Infringer13/Case-Feeder-Pro-Waveshare/README.md

# Case Feeder Pro

Firmware for an automatic brass case feeder, a bullet feeder, or both run
side by side from one controller, with a touchscreen to control them.

- **Controller:** BigTreeTech SKR Pico V1.0 (RP2040). It drives the feeder
  motors, watches the part sensors, detects and clears jams, and stores
  the settings.
- **Touchscreen:** LCDWiki ES3C28P 2.8" ESP32-S3 display. It shows each
  feeder's state, speed and rate, sounds alerts, and holds the settings.

## The feeders

### Case feeder

<p>
  Case feeder on its stand
  Case feeder hopper and plate
  Case feeder underside with the 51:1 motor and exit tube
</p>
<p>
  Case feeder underside with the exit tube
  Case feeder underside, enclosure closed
</p>

### Bullet feeder

<p>
  Bullet feeder, front view
  Bullet feeder plate, top view
  Bullet feeder underside with the 51:1 motor
</p>

### Controller case

The SKR Pico and the touchscreen share one case, with the power switch,
power jack and driver fan on its end panel. The Waveshare ESP32-S3 2.8"
lid, clamp bars, and wiring diagram are in
[`stl/waveshare-display`](stl/waveshare-display).

<p>
  Controller case, front: touchscreen, power switch, power jack and fan
  Controller case, rear: vents and USB-C port
  Controller case open, SKR Pico inside
  Controller case, bottom with mounting slots
</p>

### Exploded views

How the printed parts go together. The case feeder is shown with and without
its ABS outer wall; see [printed parts](docs/PRINTED_PARTS.md) for every file.

To turn them around and pull the parts apart yourself, open the
**[interactive 3D viewer](https://yamanub.github.io/Case-Feeder-Pro/viewer/)**
(the page is [`docs/viewer/`](docs/viewer/index.html) in this repository).

<p>
  Case feeder exploded view: outer wall, plate sections, ramps, coupler, bowl floor, base, stand and exit
  Case feeder exploded view without the outer wall
</p>
<p>
  Bullet feeder exploded view: outer shell, plate, ramp and guides, main body, base and die bracket
  Controller case exploded view: lids, sides, end caps and speaker housing
</p>

## Features

- **One firmware, three machines:** case feeder, bullet feeder, or dual
  (both). Choose on the touchscreen; no rewiring, since each feeder has its
  own ports.
- **Beam hold:** the motor stops while a part waits at the sensor and restarts
  when it is taken.
- **Jam detection and recovery:** sensorless stall detection (TMC2209
  StallGuard) reverses the plate to clear a jam, then feeds forward again. A
  jam that returns right away stops the feeder and raises an alarm.
- **Empty warning and auto shutoff** when nothing has fed for a while.
- **Five speed presets** per feeder, a live parts-per-hour rate, board
  temperature and motor-driver temperature alerts.
- **Independent feeders:** in dual mode a jam or stop on one never affects
  the other.
- The feeders keep running if the touchscreen is unplugged.

## Getting started

- [Build guide](docs/BUILD_GUIDE.md): wiring, flashing, first setup and
  daily use.
- [Parts list](docs/PARTS_LIST.md)
- [Printed parts](docs/PRINTED_PARTS.md): STL files for the feeders and the controller case
- [Controller protocol](docs/PROTOCOL.md): for running the feeders from another controller instead of the touchscreen

Both firmware images build with [PlatformIO](https://platformio.org/):

```
pio run -e controller -t upload
pio run -e lcd -t upload
```

## Case wiper

The 9mm case wiper and the outer wall it mounts on are in
[`stl/case-feeder`](stl/case-feeder). The Python generators that produced
them are in [`stl/case-feeder/scripts`](stl/case-feeder/scripts).

- `case_wiper.stl` and `case_wiper.step`: the case wiper/kicker v7 for 9mm
  brass. It mounts with M4×8 screws threading directly into 3.8 mm holes
  (no heat-set inserts) and prints flat top-down with no supports.
- `drill_template.stl`: a drill template with 4.5 mm M4 clearance holes.
- `Case Feeder Outer Wall PETG 3.2mm - wiper slots v2.stl`: the outer bowl
  wall with two wiper adjustment slots. They are 4.5 mm wide with ±2 mm of
  height travel. The slot nearest the opening is about 80 mm from the
  opening edge, with its center about 60 mm up from the bottom of the wall.

## Repository layout

| Path | Contents |
|---|---|
| `src/controller.cpp` | controller firmware (SKR Pico) |
| `src/lcd_terminal.cpp` | touchscreen firmware (ESP32-S3) |
| `src/feeder_protocol.h` | the UART protocol shared by both |
| `src/*.h` | display, touch, audio and LVGL configuration for the touchscreen |
| `lib/FT6336/` | touch controller driver |
| `docs/` | build guide, parts list, printed parts, controller protocol, and the 3D viewer (`docs/viewer/`) |
| `stl/` | 3D-printable parts plus DXF and STEP files for cut and machined parts, one folder per assembly |

## License

- **Firmware and documentation:** GNU General Public License v3.0. See
  [LICENSE](LICENSE).
- **3D models and CAD files (`stl/`, and the viewer's copies in `docs/viewer/models/`):**
  Creative Commons Attribution-NonCommercial-ShareAlike 4.0 (CC BY-NC-SA 4.0).
  See [stl/LICENSE.md](stl/LICENSE.md).
