Infringer13/Case-Feeder-Pro-Waveshare/stl/waveshare-display/waveshare-lid-v3-preview.png

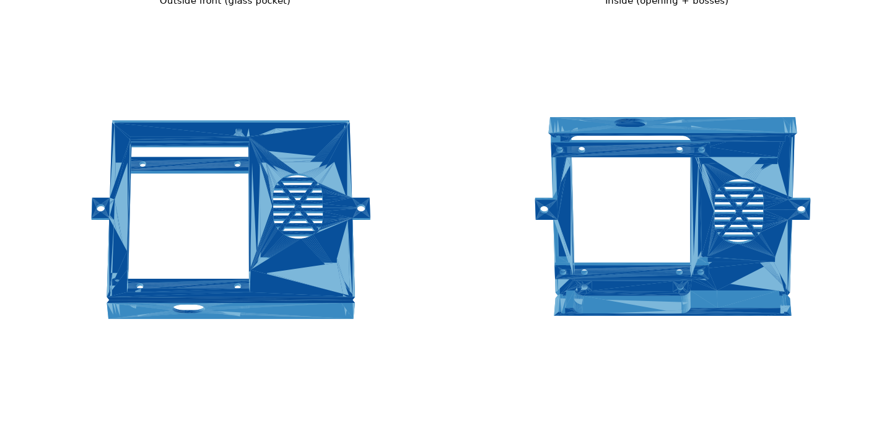
stl/waveshare-display/waveshare-lid-v3-preview.png
