Infringer13/Case-Feeder-Pro-Waveshare/docs/PRINTED_PARTS.md

# Printed parts

STL files (and the DXF and STEP files for cut and machined parts) are in
[`stl/`](../stl), one folder per assembly. Sizes are the
part's bounding box in millimetres, as exported. The models are licensed
under [CC BY-NC-SA 4.0](../stl/LICENSE.md): non-commercial use, with credit,
and modified versions shared under the same license.

## Case feeder ([`stl/case-feeder`](../stl/case-feeder))

Case feeder exploded view

The largest parts are about 292 mm long, so the case feeder needs a printer
with a bed of at least **300 x 300 mm**.

### Feeder plate (choose one)

| File | Size (mm) | Notes |
|---|---|---|
| `Feeder Plate Printed 1.stl` | 291 x 163 x 14 | printed plate, section 1 of 3 |
| `Feeder Plate Printed 2.stl` | 166 x 268 x 14 | printed plate, section 2 of 3 |
| `Feeder Plate Printed 3.stl` | 179 x 226 x 14 | printed plate, section 3 of 3 |
| `ABS Feeder Plate Milled.stl` | 334 x 334 x 4.4 | one-piece plate, milled from 3/16" ABS sheet (see the [parts list](PARTS_LIST.md)) |
| `ABS Feeder Plate Milled.step` | 334 x 334 x 4.4 | the same one-piece plate as a STEP model, for CNC machining |

| File | Size (mm) | Notes |
|---|---|---|
| `Feeder Plate Ramp V7.stl` | 167 x 167 x 6 | print 4 |

### Bowl (choose one)

Three-piece bowl, fits a 300 x 300 mm bed:

| File | Size (mm) | Notes |
|---|---|---|
| `Left Bowl V5.stl` | 170 x 202 x 173 | |
| `Mid Bowl V5.stl` | 292 x 124 x 128 | |
| `Right Bowl V5.stl` | 170 x 173 x 207 | |

One-piece bowl, for large-format printers:

| File | Size (mm) | Notes |
|---|---|---|
| `1 piece Bowl.stl` | 337 x 255 x 252 | replaces the three bowl pieces |

Outer wall (either bowl):

| File | Size (mm) | Notes |
|---|---|---|
| `ABS Outer v5.stl` | 387 x 317 x 420 | shape of the outer wall, cut from 1/16" ABS sheet; not printed |
| `ABS Outer v5 Flat.dxf` | 932 x 250 (flat) | cutting pattern for the outer wall, full size in millimetres, with the 12 screw holes along the bottom edge |

### Wiper

Printed PETG outer wall and the 9mm case wiper that mounts on it. The
generators are [`scripts/case_wiper.py`](../stl/case-feeder/scripts/case_wiper.py)
and [`scripts/make_slots_v2.py`](../stl/case-feeder/scripts/make_slots_v2.py).

| File | Size (mm) | Notes |
|---|---|---|
| `case_wiper.stl` | 18 x 50 x 36 | case wiper/kicker v7 for 9mm brass. Mounts with M4×8 screws threading directly into 3.8 mm holes (no heat-set inserts). Prints flat top-down with no supports |
| `case_wiper.step` | 18 x 50 x 36 | the same wiper as a STEP model |
| `drill_template.stl` | 4 x 50 x 36 | drill template with 4.5 mm M4 clearance holes |
| `Case Feeder Outer Wall PETG 3.2mm - wiper slots v2.stl` | 332 x 346 x 250 | outer bowl wall with two wiper adjustment slots, 4.5 mm wide with ±2 mm of height travel. The slot nearest the opening is about 80 mm from the opening edge, with its center about 60 mm up from the bottom of the wall |

### Base and mounting

| File | Size (mm) | Notes |
|---|---|---|
| `Base V5 Angle.stl` | 100 x 196 x 196 | |
| `Base Mount v5 Center.stl` | 100 x 61 x 162 | base mount, centered (choose this or Offset) |
| `Base Mount v5 Offset.stl` | 100 x 61 x 162 | base mount, offset (choose this or Center) |
| `Table Mount v5.stl` | 100 x 61 x 102 | |

### Motor coupler

| File | Size (mm) | Notes |
|---|---|---|
| `Coupler Attachment Top V7.stl` | 70 x 70 x 11 | |
| `Coupler Attachment Bottom V7.stl` | 70 x 70 x 12 | |
| `Coupler Attachment Handle.stl` | 10 x 35 x 14 | |

### Exit

| File | Size (mm) | Notes |
|---|---|---|
| `Feeder Exit.stl` | 77 x 69 x 36 | |
| `PEX Tube.stl` | 22 x 138 x 22 | length guide, not printed: the real part is 3/4" PEX tubing cut to this length (about 138 mm) |

Funnel exit (choose the one that matches your drop tube):

| File | Size (mm) | Notes |
|---|---|---|
| `Funnel Exit Dillon Tube.stl` | 27 x 30 x 27 | Dillon drop tube |
| `Funnel Exit PEX.stl` | 27 x 38 x 27 | PEX tube |
| `Funnel Exit Rollsizer Tube.stl` | 27 x 38 x 27 | Rollsizer tube |
| `Funnel Exit spring 15mm.stl` | 27 x 41 x 28 | 15 mm spring |

## Bullet feeder ([`stl/bullet-feeder`](../stl/bullet-feeder))

Bullet feeder exploded view

The largest part is about 220 mm.

| File | Size (mm) | Notes |
|---|---|---|
| `Main Body.stl` | 191 x 10 x 220 | |
| `Base Mount.stl` | 131 x 71 x 192 | |
| `Base Spring Connector.stl` | 27 x 27 x 42 | |
| `Ramp.stl` | 63 x 23 x 50 | |
| `Guide.stl` | 51 x 6 x 53 | |
| `Guide Stop.stl` | 18 x 13 x 35 | |
| `ABS outer shell Wrap.stl` | 198 x 127 x 193 | shape of the outer wall, cut from 1/16" ABS sheet; not printed |
| `ABS outer shell Wrap Flat.dxf` | 487 x 127 (flat) | cutting pattern for the outer wall, full size in millimetres, with the 5 screw holes along the bottom edge |

Feeder plate (choose your caliber):

| File | Size (mm) | Notes |
|---|---|---|
| `Feeder Plate 9mm.stl` | 188 x 29 x 188 | 9 mm |
| `Feeder Plate 45ACP.stl` | 188 x 29 x 188 | .45 ACP |

Die bracket and cover (choose your press and caliber):

| File | Size (mm) | Notes |
|---|---|---|
| `Dillon Die Bracket 9.stl` | 19 x 115 x 99 | Dillon, 9 mm |
| `Dillon Die Bracket-45.stl` | 19 x 116 x 99 | Dillon, .45 |
| `DAA Die Bracket 9.stl` | 19 x 115 x 99 | DAA, 9 mm |
| `Die Bracket Cover 9.stl` | 19 x 81 x 63 | 9 mm |
| `Die Bracket Cover-45.stl` | 19 x 81 x 63 | .45 |

## Controller case ([`stl/controller-case`](../stl/controller-case))

Controller case exploded view

Holds the SKR Pico and the touchscreen.

| File | Size (mm) | Notes |
|---|---|---|
| `CFBF Top Cap.stl` | 17 x 90 x 57 | |
| `CFBF Bottom Cap.stl` | 17 x 90 x 57 | |
| `CFBF Center Side 1.stl` | 118 x 23 x 14 | |
| `CFBF Center Side 2.stl` | 118 x 23 x 14 | |
| `CFBF LCD Lid.stl` | 118 x 90 x 21 | touchscreen side |
| `CFBF Pico Lid.stl` | 118 x 90 x 22 | SKR Pico side |
| `CFBF Speaker Housing.stl` | 32 x 47 x 13 | |

## Waveshare display ([`stl/waveshare-display`](../stl/waveshare-display))

Lid and clamp bars for a Waveshare ESP32-S3-Touch-LCD-2.8 in the controller
case. The wiring diagram, generator, and preview are in that folder; see
its [README](../stl/waveshare-display/README.md).

| File | Size (mm) | Notes |
|---|---|---|
| `CFBF LCD Lid Waveshare Flush v3.stl` | 118 x 90 x 21 | controller-case lid that holds the display flush. The glass sits in an outside pocket |
| `Waveshare Rear Bar x2.stl` | 66.5 x 19 x 3 | print 2. The file is the pair of rear bars that clamp the board |

## Case arm mount ([`stl/case-arm-mount`](../stl/case-arm-mount))

The arm that attaches the controller case to the case feeder or the bullet
feeder.

| File | Size (mm) | Notes |
|---|---|---|
| `Arm - BoltSide.stl` | 42 x 15 x 15 | |
| `Arm - NutSide.stl` | 42 x 15 x 15 | |
| `Ball End.stl` | 18 x 20 x 18 | |
| `Ball Nut.stl` | 30 x 12 x 30 | |
| `Screw Attachment.stl` | 23 x 13 x 23 | attaches the case arm to the feeder |
