Infringer13/Case-Feeder-Pro-Waveshare/stl/case-feeder/drill_template.stl

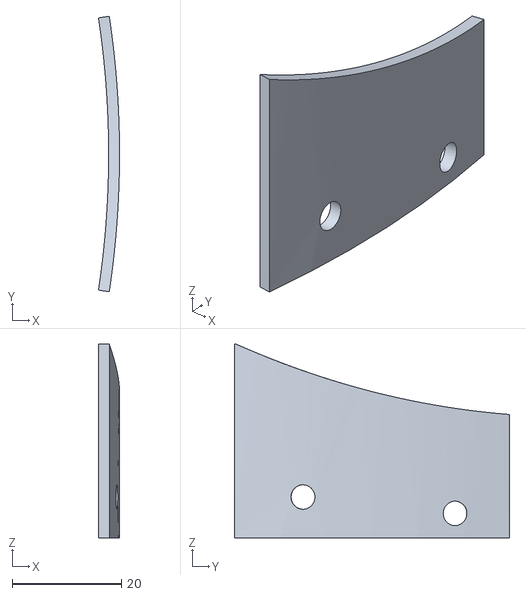
[picture p2: CAD file, 2026-11-05]
stl/case-feeder/drill_template.stl
3.86 x 50.4 x 35.5
