Infringer13/Case-Feeder-Pro-Waveshare/stl/waveshare-display/CFBF LCD Lid Waveshare Flush v3.stl

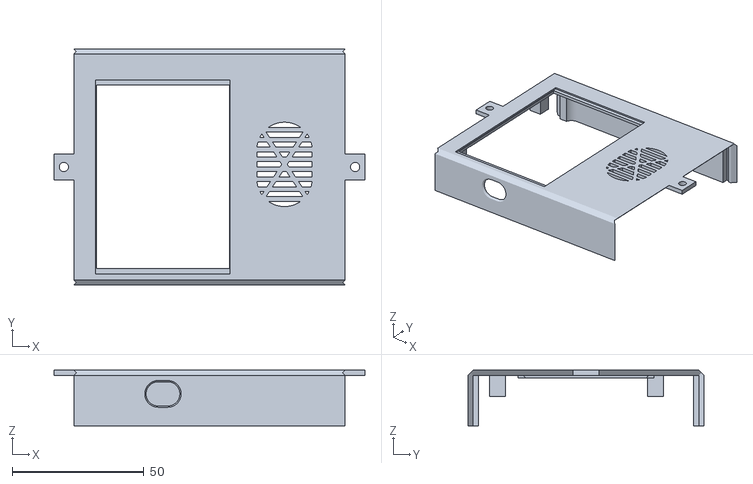
[picture p3: CAD file, 2026-11-05]
stl/waveshare-display/CFBF LCD Lid Waveshare Flush v3.stl
118.0 x 89.6 x 21.1
