Infringer13/Case-Feeder-Pro-Waveshare/stl/case-feeder/case_wiper.step

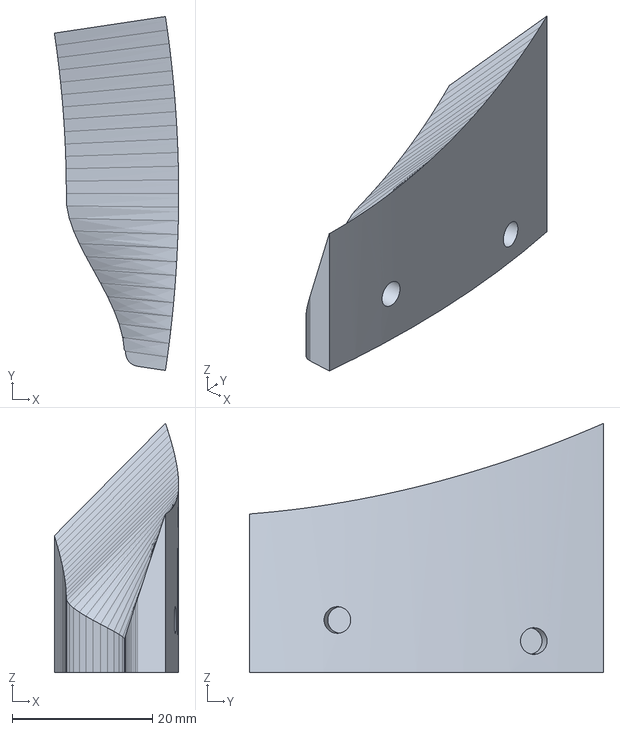
[picture p4: CAD file, 2026-11-05]
stl/case-feeder/case_wiper.step
17.7 x 50.4 x 35.5 mm
