Infringer13/Case-Feeder-Pro-Waveshare/stl/waveshare-display/Waveshare Rear Bar x2.stl

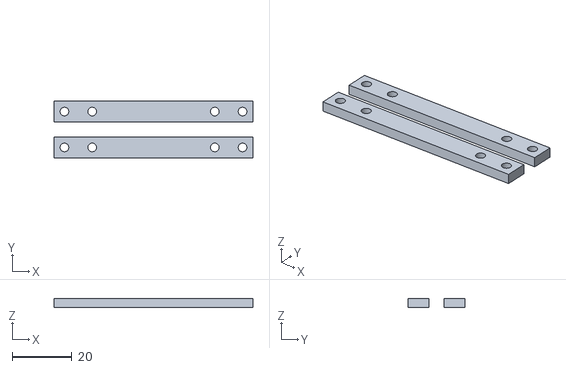
[picture p5: CAD file, 2026-11-05]
stl/waveshare-display/Waveshare Rear Bar x2.stl
66.5 x 19.0 x 3.00
