Infringer13/Case-Feeder-Pro-Waveshare/stl/case-feeder/Case Feeder Outer Wall PETG 3.2mm - wiper slots v2.stl

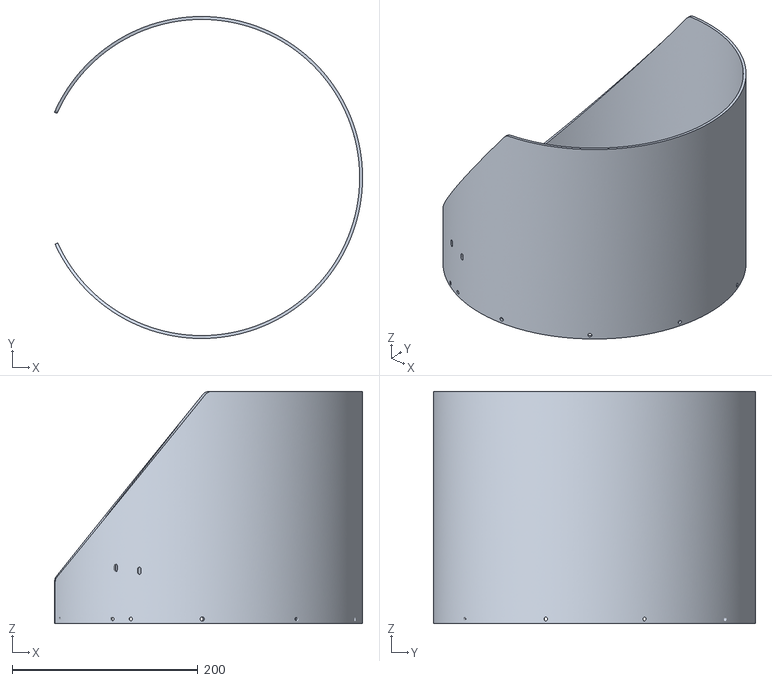
[picture p6: CAD file, 2026-11-05]
stl/case-feeder/Case Feeder Outer Wall PETG 3.2mm - wiper slots v2.stl
331.5 x 346.4 x 250.0
