Infringer13/Case-Feeder-Pro-Waveshare/(list of files, cad)

Other CAD files:
stl/case-feeder/case_wiper.stl
