Infringer13/Case-Feeder-Pro-Waveshare/(commit log)

2026-10-31 Add a Waveshare ESP32-S3-Touch-LCD-2.8 firmware env
    Keep the LCDWiki ES3C28P lcd build and add lcd_waveshare for the
    ST7789, CST328 and PCM5101 pinout from Waveshare's wiki and demo.
    UART to the SKR Pico stays on GPIO43/44, and the ES3C28P amp-enable
    on GPIO1 is not built for this board.
2026-11-01 Detect CST3530 touch on Waveshare V2 boards
    The V2 / Rev1.1 board uses a CST3530 at I2C 0x58. Follow Waveshare's
    V2 demo: try the CST328 signature 0xCACA, then the CST3530 reset and
    read sequence, on the same touch pins.
    [display_config.h, lcd_terminal.cpp, lvgl_driver.h]
2026-11-01 Document Waveshare V1/V2 wiring to the SKR Pico
    Spell out the SH1.0 UART and 12-pin headers, VBus power, the single
    ground, and the 1.25 mm speaker plug from Waveshare's schematic.
2026-11-02 Waveshare LCD: fix boot crash, colors and panel init (hardware verified)
    [lvgl_driver.h]
2026-11-05 Add the 9mm case wiper, drill template, and slotted outer wall
    Place the STL and STEP models in stl/case-feeder and the generator
    scripts in stl/case-feeder/scripts. Document the mounting holes,
    print orientation, and wiper slots.
    [Case Feeder Outer Wall PETG 3.2mm - wiper slots v2.stl, case_wiper.step, case_wiper.stl, drill_template.stl]
2026-11-05 Add the Waveshare 2.8" display lid, clamp bars, and wiring diagram
    Place the STL, PDF, generator, and preview in stl/waveshare-display
    with a short README, and link that folder from the printed-parts list.
    [CFBF LCD Lid Waveshare Flush v3.stl, Waveshare Rear Bar x2.stl]
2026-11-05 Detect a full StallGuard stall and back it up with the beam.
    A stopped rotor reads SG_RESULT 0, which the poll used to ignore, so a jam on the 51:1 gearbox never reversed. Count that 0 while stepping at speed, read DIAG with a pull-up, and treat a feed-speed run with no part for 6 seconds as the same recovery.
    [controller.cpp]
2026-11-05 Make the beam the jam signal and stop an empty hopper.
    A counted case is a confirmed block followed by a confirmed clear, so sensor flicker no longer postpones a jam. After three recoveries with no counted case, stop and show the existing empty shutoff instead of reversing again.
    [controller.cpp]
2026-11-05 Count a case on a short beam block.
    Fast brass never sat through the hold clear, so the no-case clock never reset. Count after 40 ms blocked, re-arm after 50 ms clear, and wait 8 s / 5 empty reversals before stopping.
    [controller.cpp]
